hardik01shah/digital-scanner-mpi-2021/Hardware Design and Pinouts.pdf

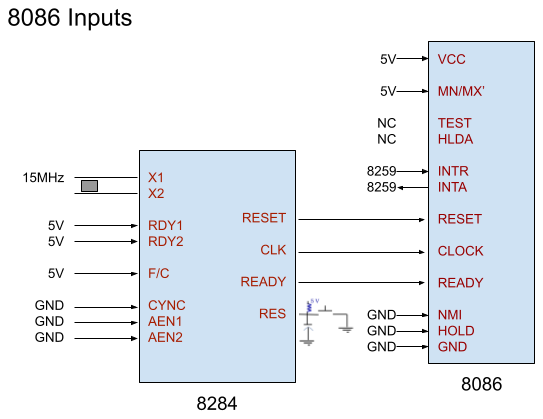
[picture p8: figure]

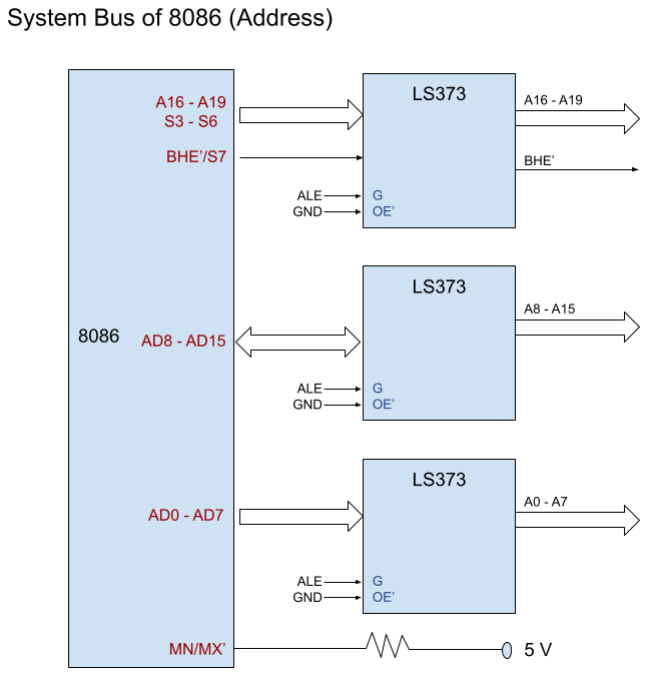
[picture p9: figure]

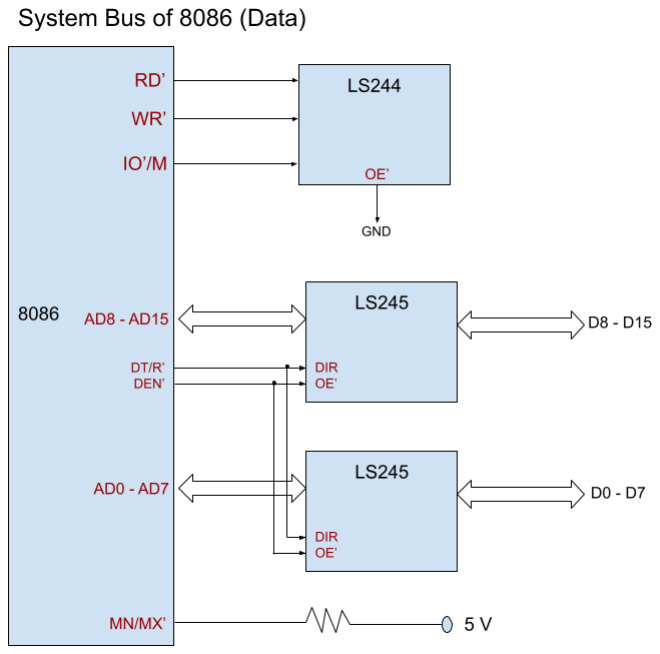
[picture p10: figure]
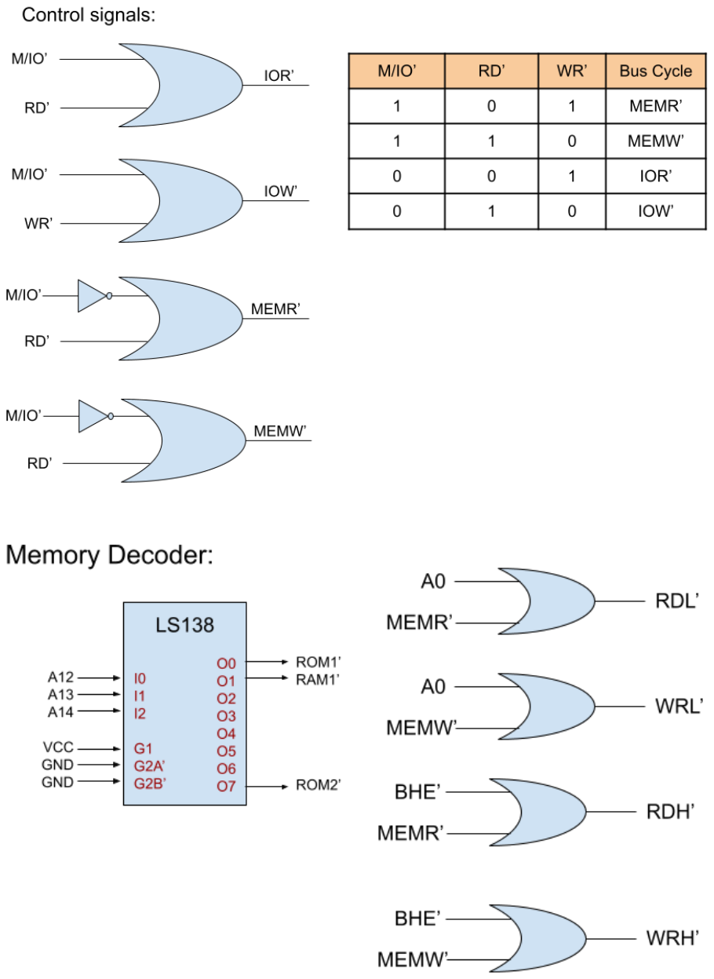
[picture p11: page 4]
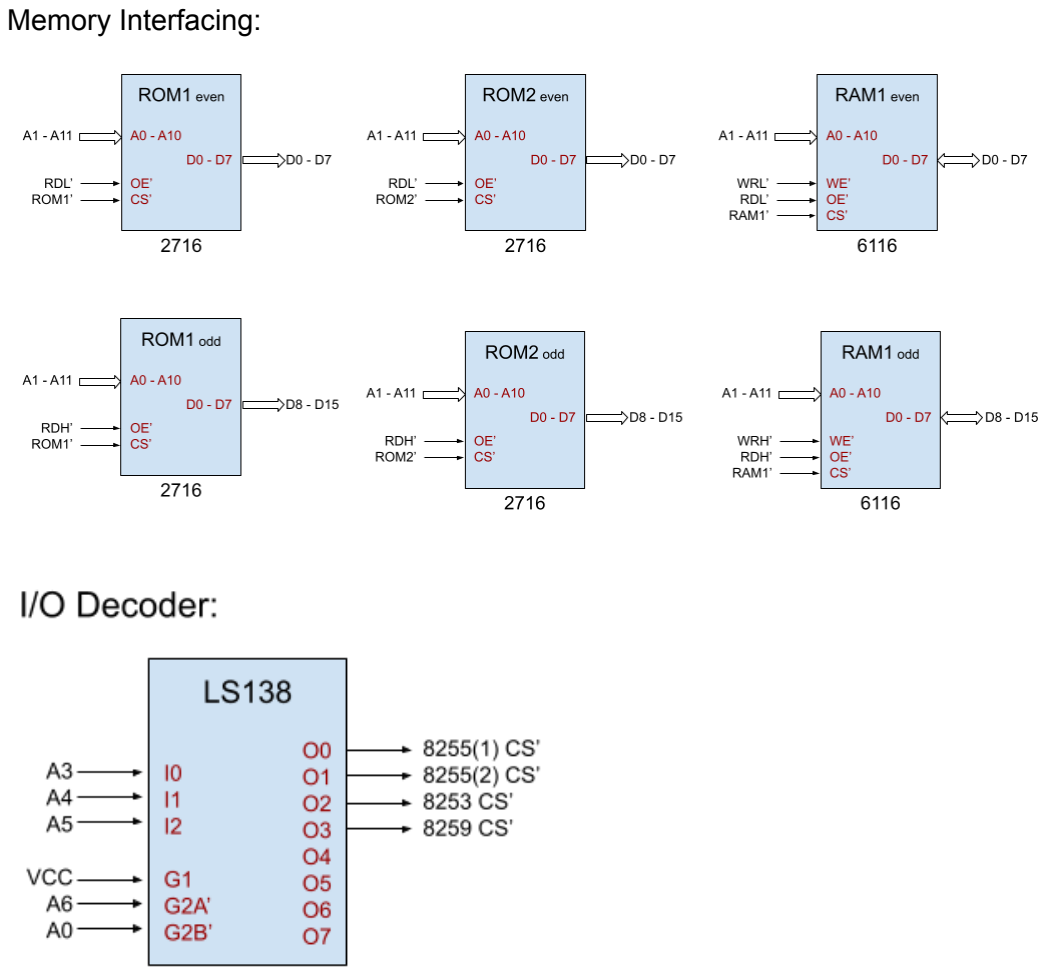
[picture p12: page 5]

Memory Interfacing:

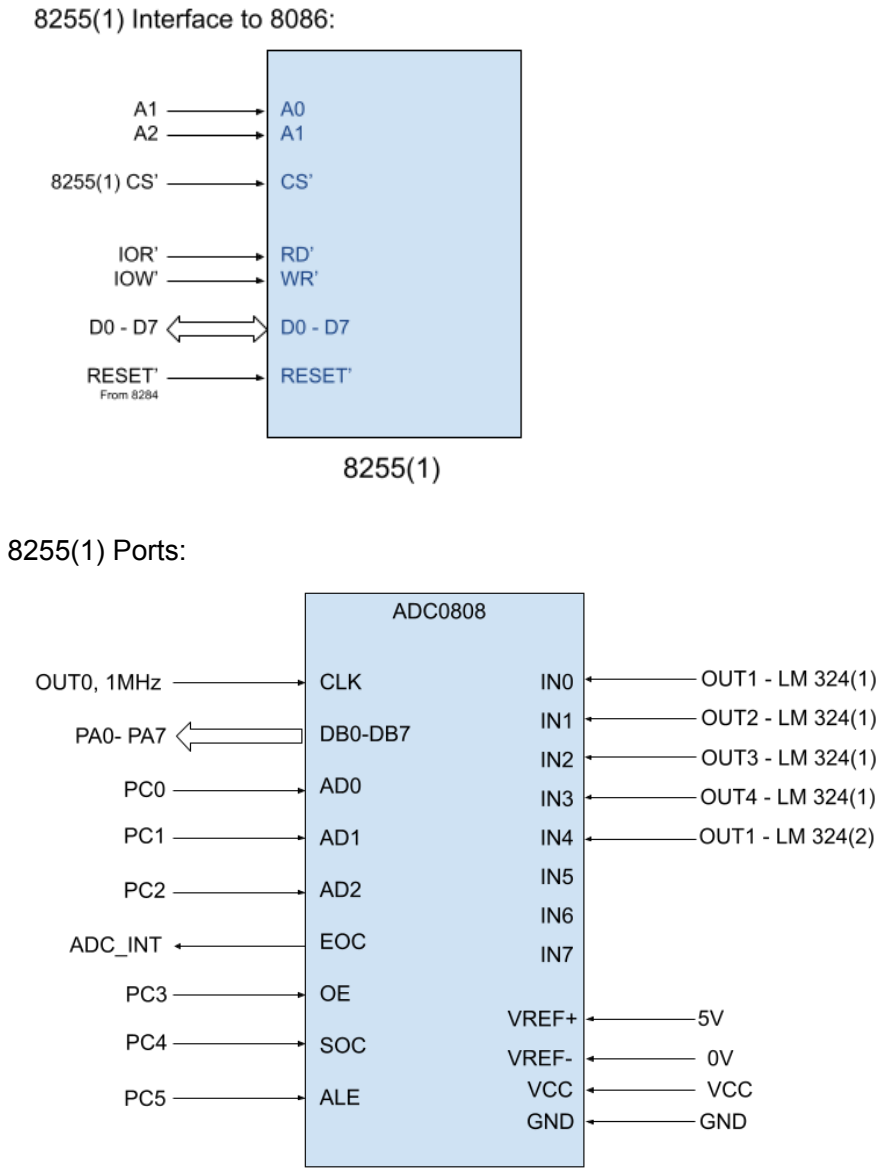
[picture p13: page 6]

### 8255(1) Ports:

For Op-Amp:
Max Current in PD = 5 mA
We want voltage between 0 and 5V, so max voltage = 5V R = V/I = 5V/5mA = 1 kOhm

For LED:
Average Current for max lumination = 30 mA
R = V/I = 5000 mV/30mA ~ 180 ohm

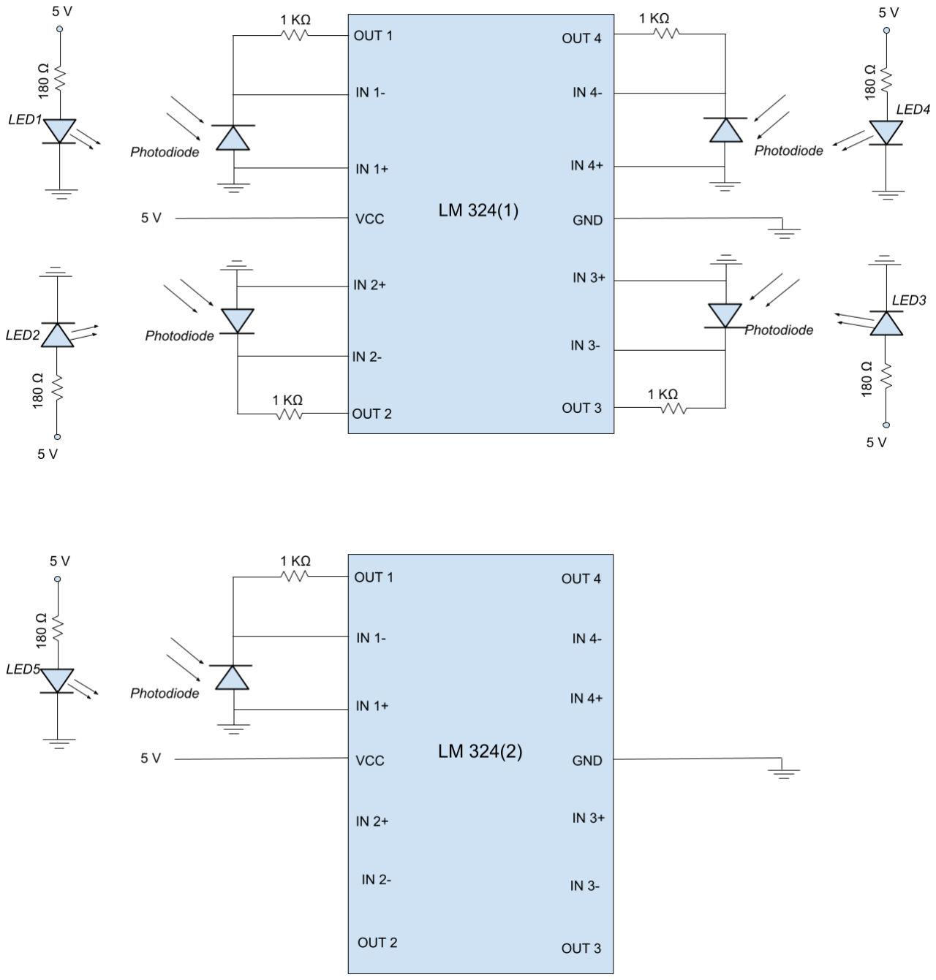
[picture p14: figure]
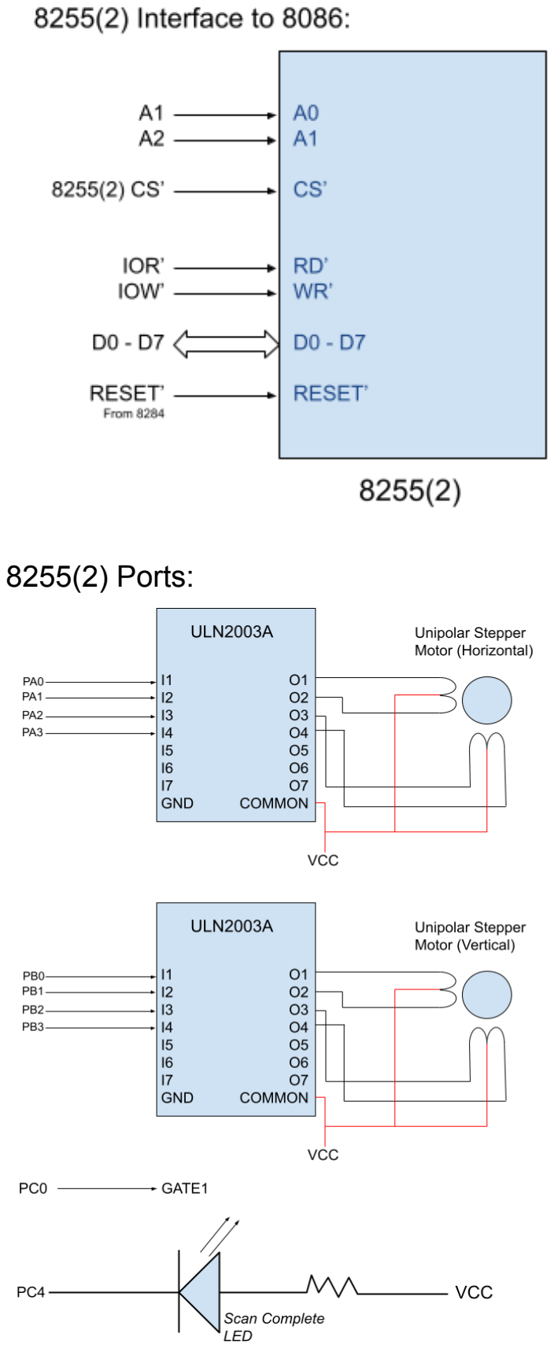
[picture p15: page 8]

### 8255(2) Ports:

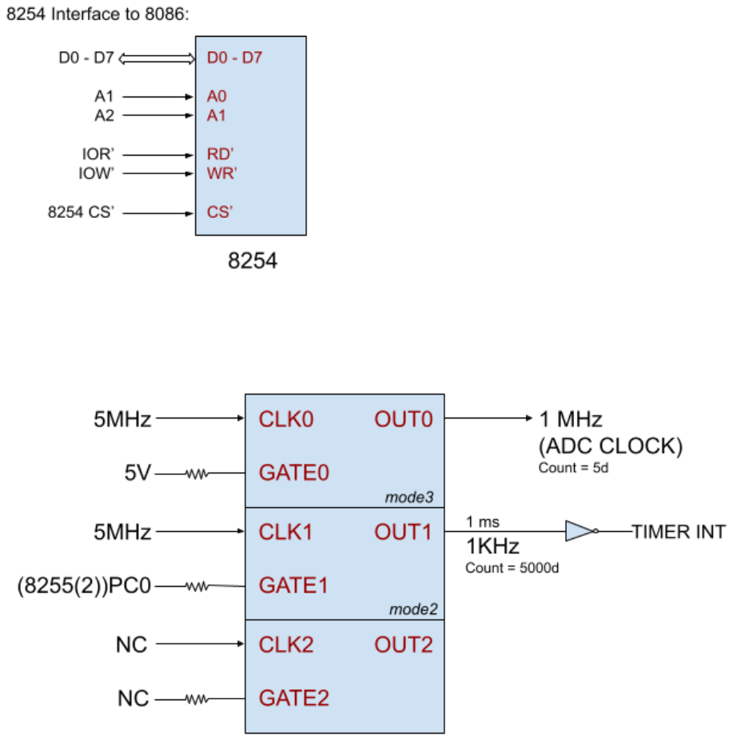
[picture p16: page 9]

8259 Interface to 8086:

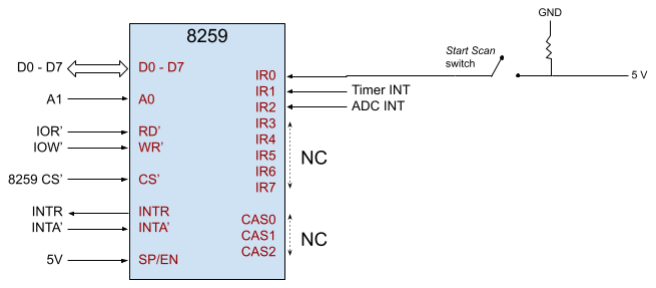
[picture p17: figure]
