hardik01shah/digital-scanner-mpi-2021/(list of files, drawings)

Other design files:
Scanner.DSN
