hardik01shah/digital-scanner-mpi-2021/(commit log)

2021-05-10 added assembly files
2021-05-10 added proteus file
    [Scanner.DSN]
